matthiasbock/encoders-and-buttons-board/build/v1.0/schematic.pdf

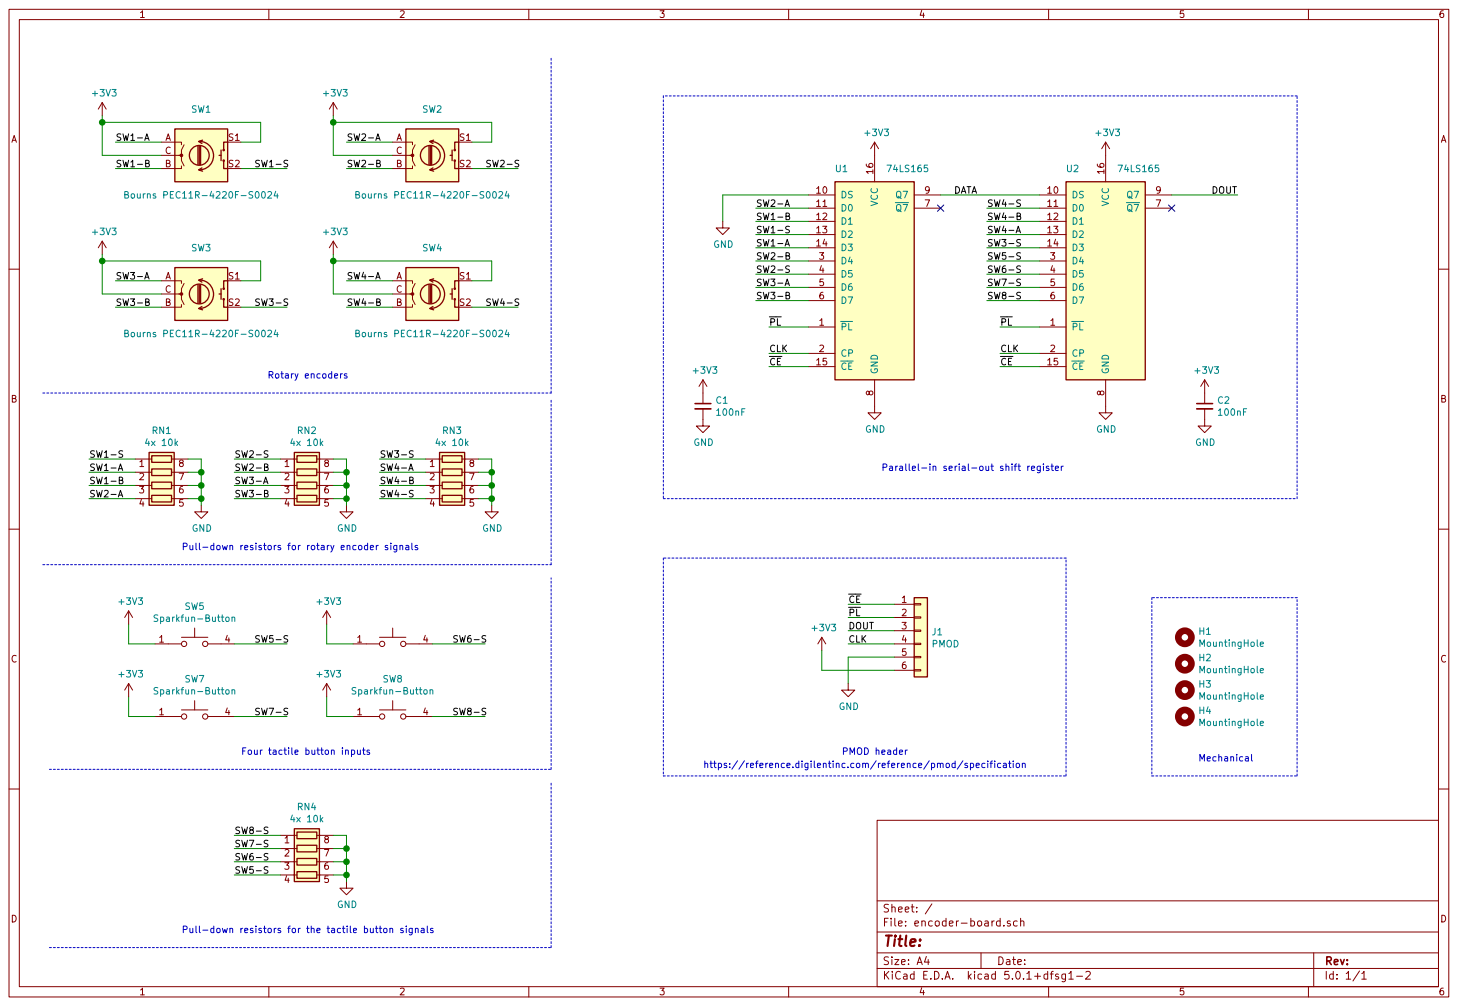
[picture p1: page 1]

8 Q7 9 U1 74LS165 PL 1 DS 10 D0 11 D1 12 D2 13 D3 14 CE 15 VCC 16 CP 2 D4 3 D5 4 D6 5 D7 6 Q7 7 GND

Pull-down resistors for rotary encoder signals GND

https://reference.digilentinc.com/reference/pmod/specification

Id: 1/1 Title: File: encoder-board.sch Sheet: /
