matthiasbock/encoders-and-buttons-board/encoder-board.kicad_pcb

## KiCad design encoder-board.kicad_pcb (2019-02-05)

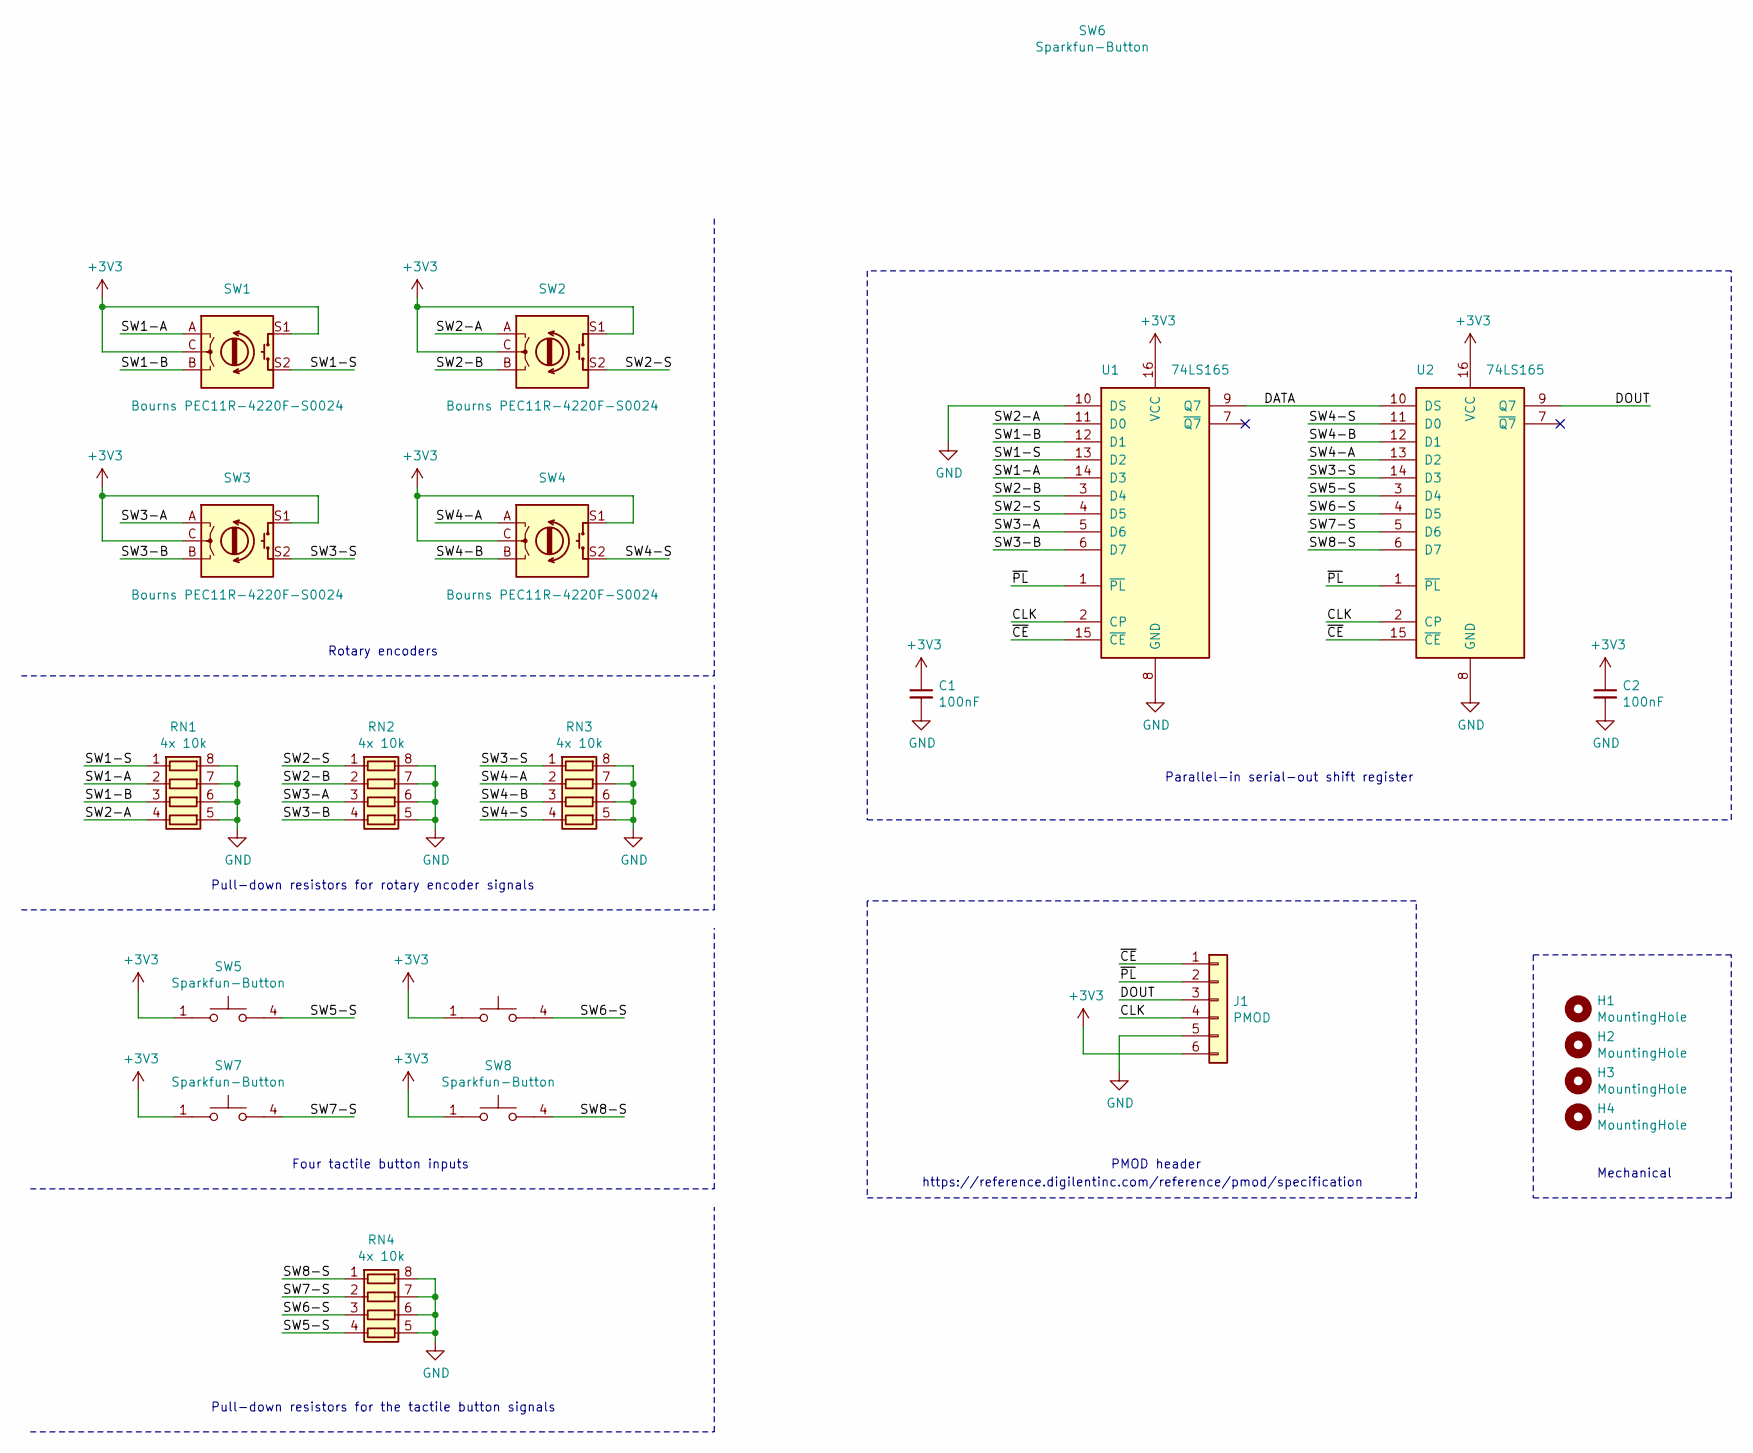
[picture p2: schematic encoder-board.sch]

Parts:
C1, C2: 100nF; C_0805_2012Metric_Pad1.15x1.40mm_HandSolder
H1, H2, H3, H4: MountingHole; MountingHole_2.5mm
J1: PMOD; PinHeader_1x06_P2.54mm_Vertical
RN1, RN2, RN3, RN4: 4x 10k; Bourns-CAY16
SW1, SW2, SW3, SW4: Bourns PEC11R-4220F-S0024; Bourns-PEC11R
SW5, SW6, SW7, SW8: Sparkfun-Button
U1, U2: 74LS165; SOIC-16_3.9x9.9mm_P1.27mm

Connections:
+3V3: C1.1, C2.1, J1.6, SW1.C, SW1.S1, SW2.C, SW2.S1, SW3.C, SW3.S1, SW4.C, SW4.S1, SW5.1, SW5.2, SW6.1, SW6.2, SW7.1, SW7.2, SW8.1, SW8.2, U1.16 (VCC), U2.16 (VCC)
/CLK: J1.4, U1.2 (CP), U2.2 (CP)
/DATA: U1.9 (Q7), U2.10 (DS)
/DOUT: J1.3, U2.9 (Q7)
/SW1-A: RN1.2 (R2.1), SW1.A, U1.14 (D3)
/SW1-B: RN1.3 (R3.1), SW1.B, U1.12 (D1)
/SW1-S: RN1.1 (R1.1), SW1.S2, U1.13 (D2)
/SW2-A: RN1.4 (R4.1), SW2.A, U1.11 (D0)
/SW2-B: RN2.2 (R2.1), SW2.B, U1.3 (D4)
/SW2-S: RN2.1 (R1.1), SW2.S2, U1.4 (D5)
/SW3-A: RN2.3 (R3.1), SW3.A, U1.5 (D6)
/SW3-B: RN2.4 (R4.1), SW3.B, U1.6 (D7)
/SW3-S: RN3.1 (R1.1), SW3.S2, U2.14 (D3)
/SW4-A: RN3.2 (R2.1), SW4.A, U2.13 (D2)
/SW4-B: RN3.3 (R3.1), SW4.B, U2.12 (D1)
/SW4-S: RN3.4 (R4.1), SW4.S2, U2.11 (D0)
/SW5-S: RN4.4 (R4.1), SW5.3, SW5.4, U2.3 (D4)
/SW6-S: RN4.3 (R3.1), SW6.3, SW6.4, U2.4 (D5)
/SW7-S: RN4.2 (R2.1), SW7.3, SW7.4, U2.5 (D6)
/SW8-S: RN4.1 (R1.1), SW8.3, SW8.4, U2.6 (D7)
/~CE: J1.1, U1.15 (~CE), U2.15 (~CE)
/~PL: J1.2, U1.1 (~PL), U2.1 (~PL)
GND: C1.2, C2.2, J1.5, RN1.5 (R4.2), RN1.6 (R3.2), RN1.7 (R2.2), RN1.8 (R1.2), RN2.5 (R4.2), RN2.6 (R3.2), RN2.7 (R2.2), RN2.8 (R1.2), RN3.5 (R4.2), RN3.6 (R3.2), RN3.7 (R2.2), RN3.8 (R1.2), RN4.5 (R4.2), RN4.6 (R3.2), RN4.7 (R2.2), RN4.8 (R1.2), U1.8 (GND), U1.10 (DS), U2.8 (GND)

Notes on the sheet:
Rotary encoders
Pull-down resistors for rotary encoder signals
Four tactile button inputs
Pull-down resistors for the tactile button signals
Parallel-in serial-out shift register
PMOD header
https://reference.digilentinc.com/reference/pmod/specification
Mechanical

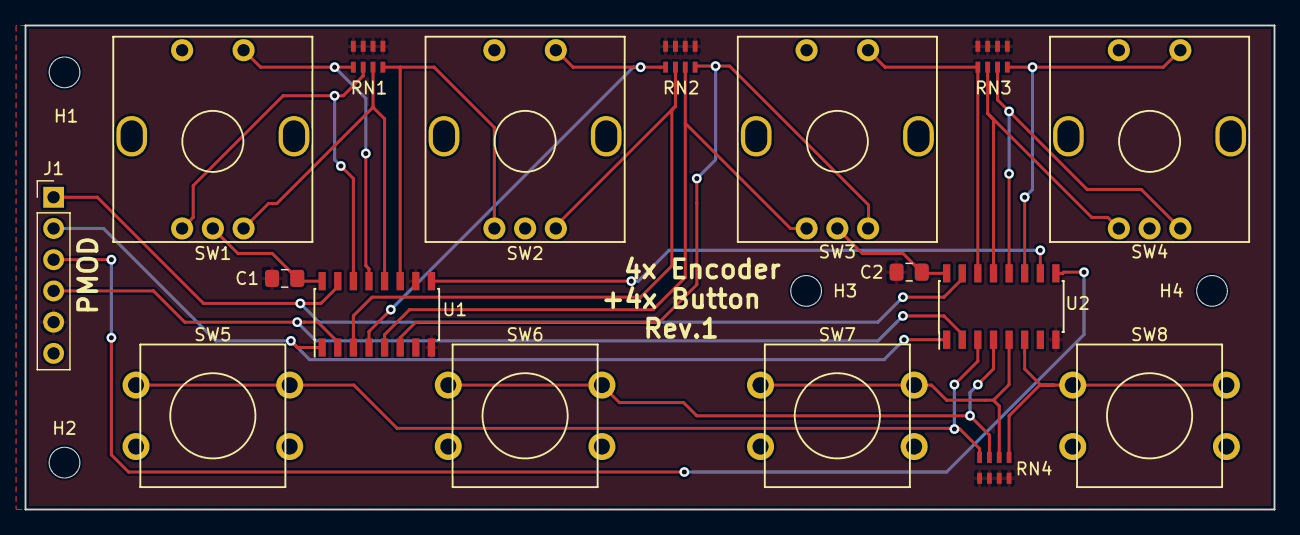
[picture p3: board encoder-board.kicad_pcb from above]

Board: 2 copper layers, 101.6 x 39.4 mm, 21 parts (0 on the bottom side), 23 nets.
