matthiasbock/encoders-and-buttons-board/(threads)

Thread 1 (2019-02-21):

v1.0: Mounting holes are too narrow

matthiasbock, 2019-02-21:
An M3 screw should fit. Right now it's too tight, for M3 to fit through.

Thread 2 (2019-02-21):

v1.0: Encoder mounting holes are not high enough

matthiasbock, 2019-02-21:
The holes for the encoder's side clamps are not high enough for the encoder to conveniently fit into the board. They should be about 0.5mm higher. The hole center can stay the same, the other holes too.

Thread 3 (2019-02-21):

v1.0: Resistor network footprint is suboptimal

matthiasbock, 2019-02-21:
The used footprint for the Bourns 10k resistor networks are usable but not a good fit for the actual landing pattern of the component. The outer four pads are bigger, then the inner ones. That should be enhanced.

Thread 4 (2019-02-26):

v1.0: Additional mounting holes required

matthiasbock, 2019-02-26:
There are four, but M3 and M4 are placed suboptimal. When pressing a button, the board tilts. It would be better, if at the right edge of the board there would be two mounting holes in the corners respectively.

Thread 5 (2019-02-26):

v1.0: Buttons and encoder holes not centered

matthiasbock, 2019-02-26:
The holes of buttons and encoders are not centered in their respective board halfs. The encoder holes are lying more inside the board, while the buttons are closer to the board edge. It would be better, if that would be symmetrical.
