matthiasbock/encoders-and-buttons-board/(commit log)

2019-02-04 Added KiCad libraries as submodule
2019-02-04 Completed first draft for the schematic
    [encoder-board.sch]
2019-02-05 Using PMOD compatible pin layout
    [encoder-board.sch]
2019-02-05 Finished layouting revision 1
    [encoder-board.kicad_pcb, encoder-board.sch]
2019-02-05 Added a label to the silkscreen
    [encoder-board.kicad_pcb]
2019-02-06 Exported fabrication files
    [encoder-board-B.Cu.gbr, encoder-board-B.Mask.gbr, encoder-board-B.SilkS.gbr, encoder-board-Edge.Cuts.gbr, encoder-board-F.Cu.gbr, encoder-board-F.Mask.gbr, encoder-board-F.SilkS.gbr, encoder-board-NPTH.drl]
2019-03-19 Added schematic PDF for revision 1.0
    [encoder-board-B.Cu.gbr, encoder-board-B.Mask.gbr, encoder-board-B.SilkS.gbr, encoder-board-Edge.Cuts.gbr, encoder-board-F.Cu.gbr, encoder-board-F.Mask.gbr, encoder-board-F.SilkS.gbr, encoder-board-NPTH.drl]
